pibrnik/metamaterials/Renders/BaseCell_v1.JPG

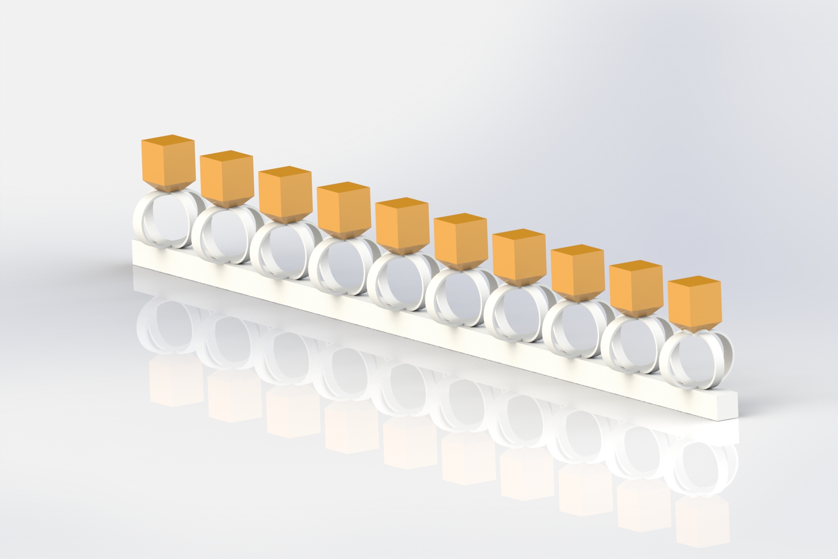
Renders/BaseCell_v1.JPG
