pibrnik/metamaterials/Renders/BaseCell_v12JPG.JPG

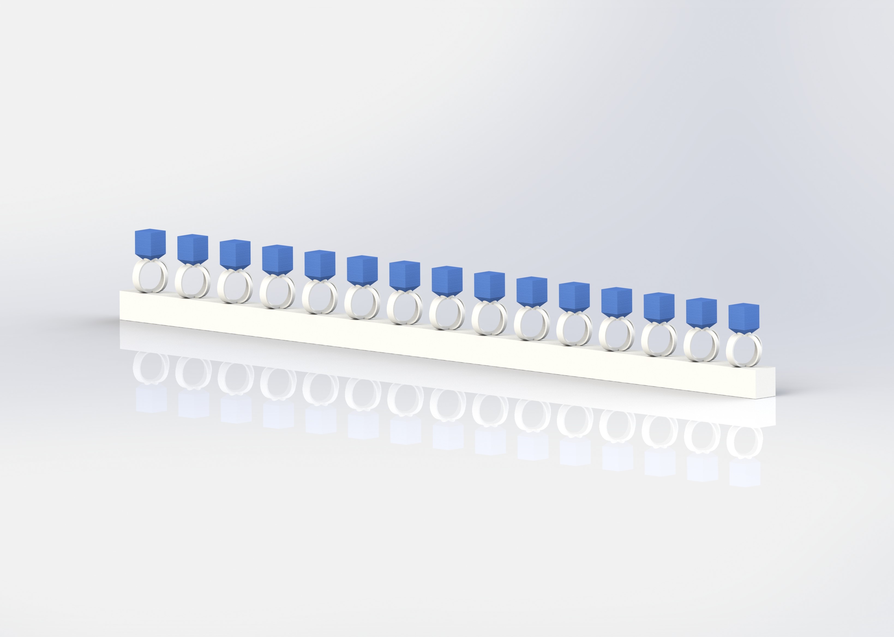
Renders/BaseCell_v12JPG.JPG
