pibrnik/metamaterials/Skica problema.png

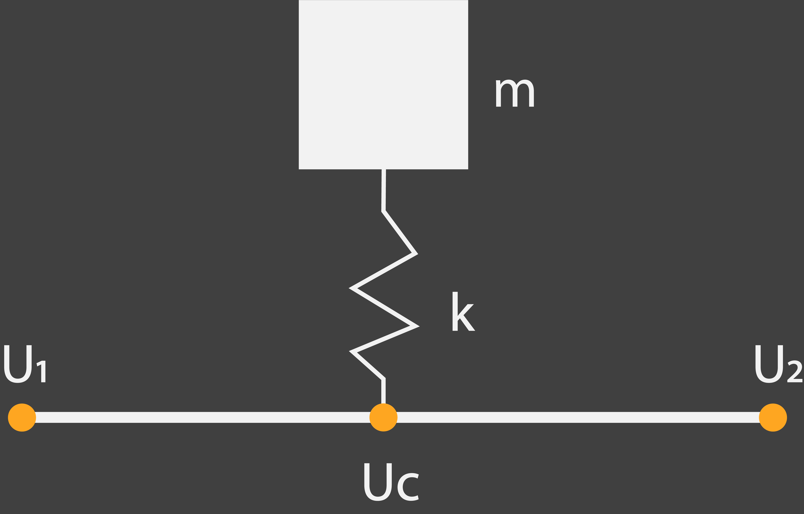
Skica problema.png
