pibrnik/metamaterials/Solidworks/BaseCell_v4.JPG

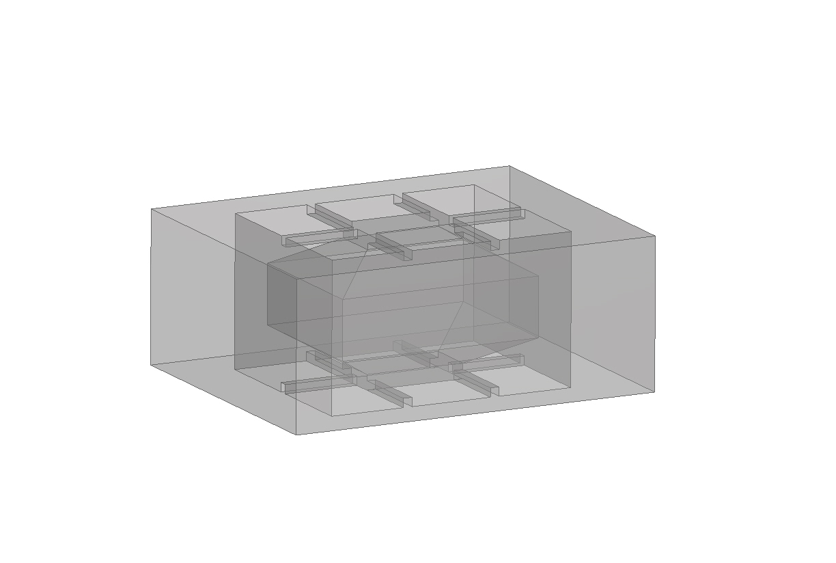
Solidworks/BaseCell_v4.JPG
