pibrnik/metamaterials/Solidworks/BaseCell_v4_drawing.JPG

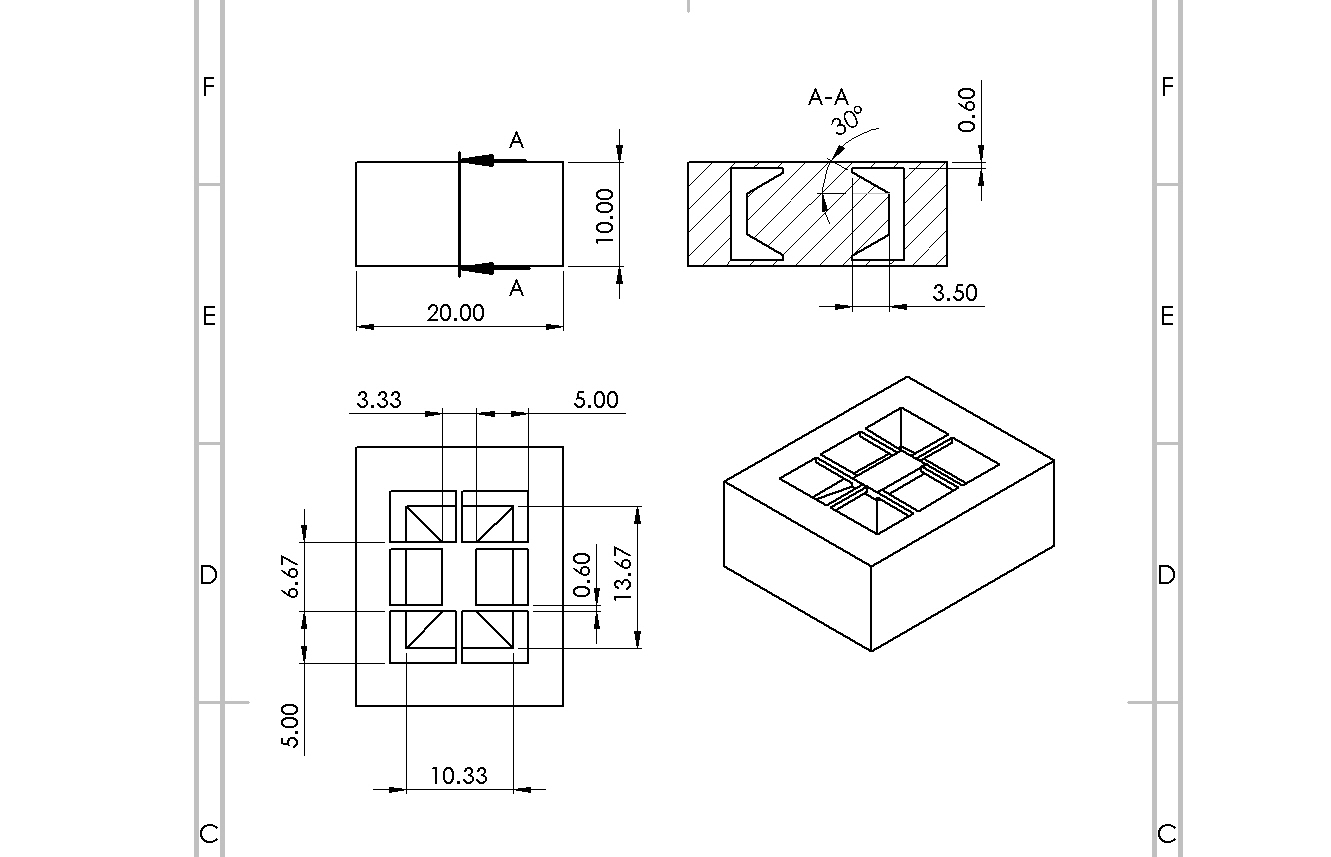
Solidworks/BaseCell_v4_drawing.JPG
