pibrnik/metamaterials/Animations/Metamaterial_oblika_1_mu_0.785.png

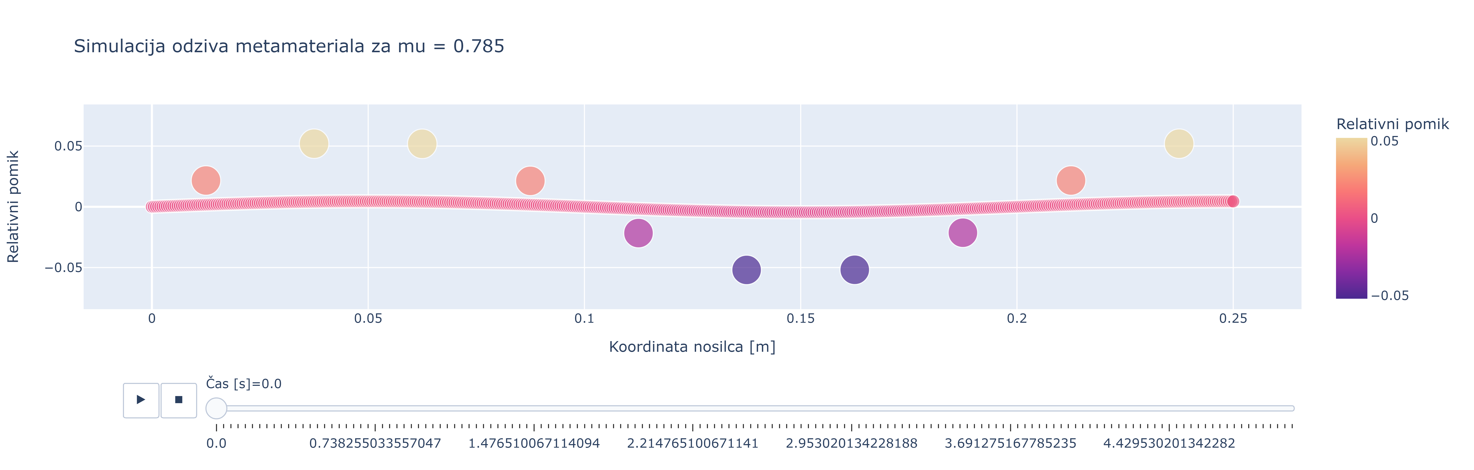
Animations/Metamaterial_oblika_1_mu_0.785.png
