pibrnik/metamaterials/Animations/Metamaterial_oblika_2_mu_0.785.png

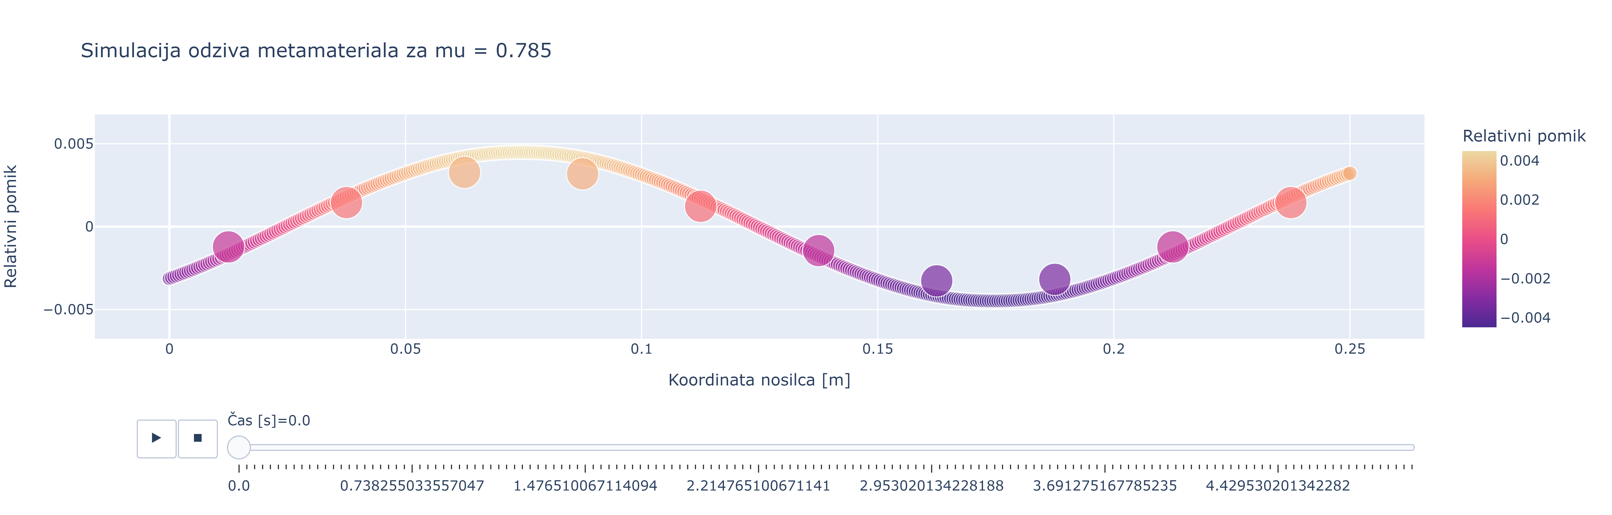
Animations/Metamaterial_oblika_2_mu_0.785.png
