pibrnik/metamaterials/Ansys/Models/Tester.STEP

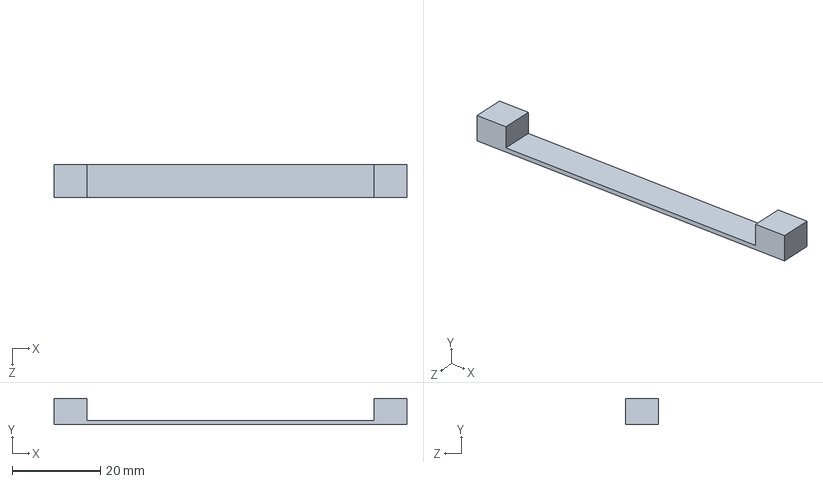
[picture p36: CAD file, 2023-01-15]
Ansys/Models/Tester.STEP
80.0 x 6.00 x 7.50 mm
