pibrnik/metamaterials/parametricBaseCell_v2.SLDPRT

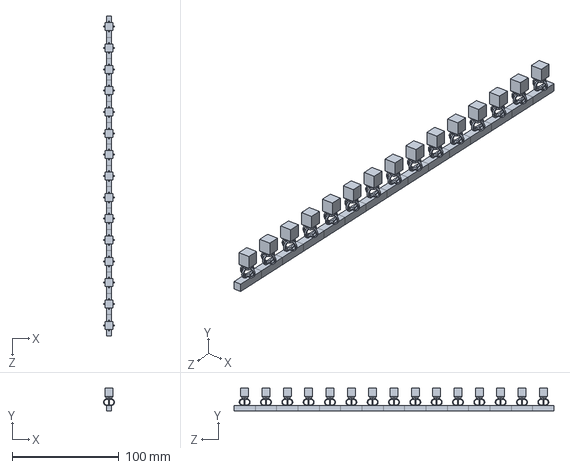
[picture p37: CAD file, 2022-12-26]
parametricBaseCell_v2.SLDPRT
10.4 x 21.4 x 300.0 mm
