pibrnik/metamaterials/Solidworks/DensityCube_15.STL

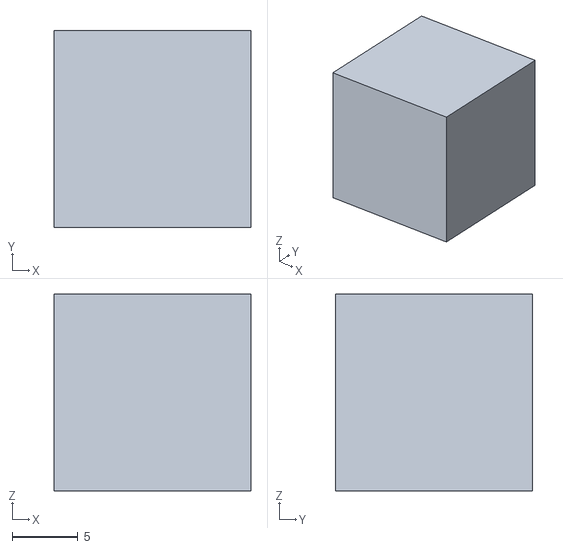
[picture p38: CAD file, 2023-01-15]
Solidworks/DensityCube_15.STL
15.0 x 15.0 x 15.0
