pibrnik/metamaterials/Ansys/Models/BaseCell_v4.STEP

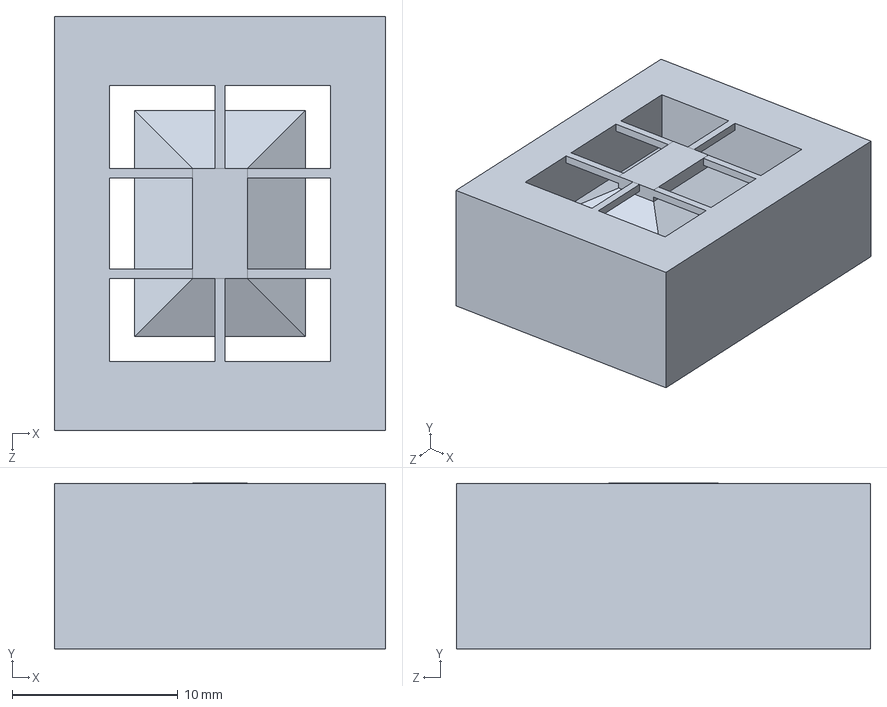
[picture p39: CAD file, 2022-12-26]
Ansys/Models/BaseCell_v4.STEP
20.0 x 10.0 x 25.0 mm
