pibrnik/metamaterials/Ansys/Models/Spring_5_0.5_2.5_2.STEP

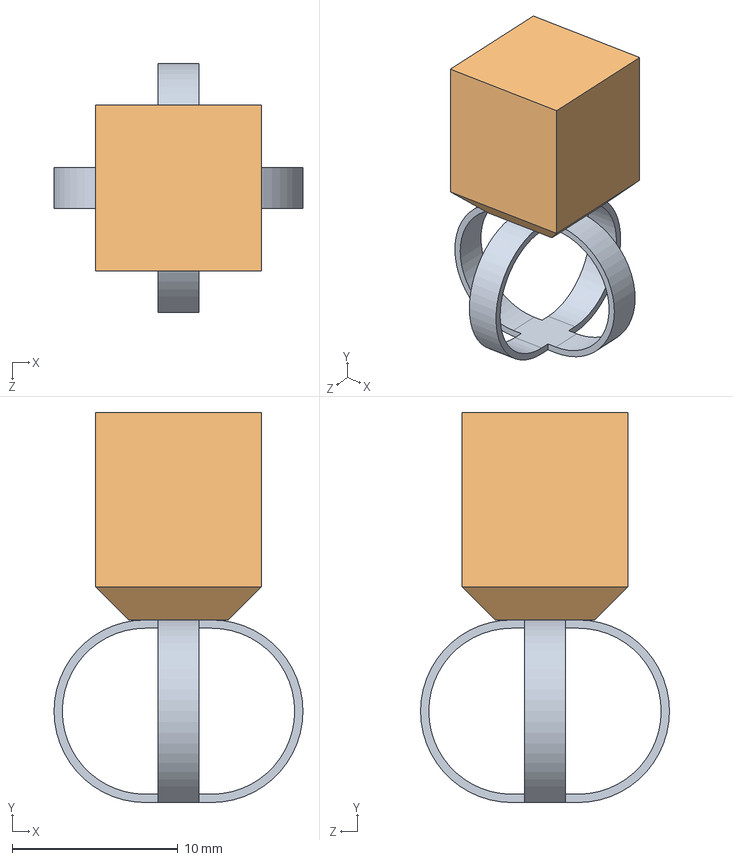
[picture p40: CAD file, 2022-12-26]
Ansys/Models/Spring_5_0.5_2.5_2.STEP
15.0 x 23.5 x 15.0 mm
