pibrnik/metamaterials/Ansys/Models/V3.SLDPRT

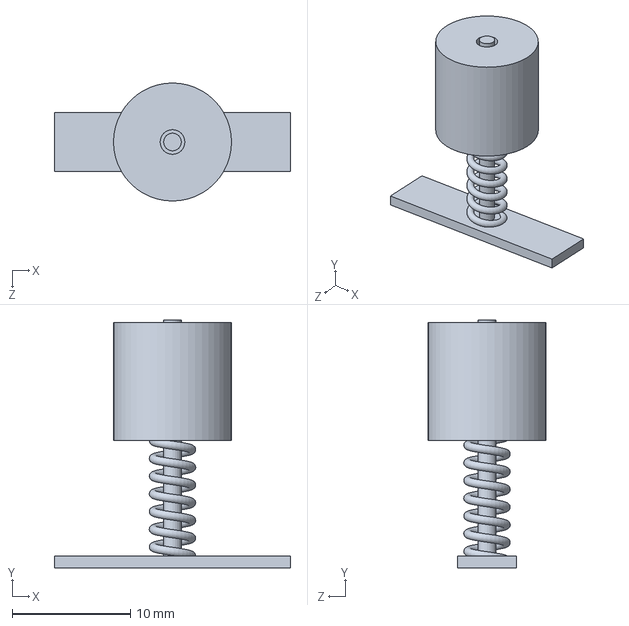
[picture p41: CAD file, 2022-12-26]
Ansys/Models/V3.SLDPRT
20.0 x 21.0 x 10.0 mm
