pibrnik/metamaterials/Solidworks/BaseCell_v4x10.STL

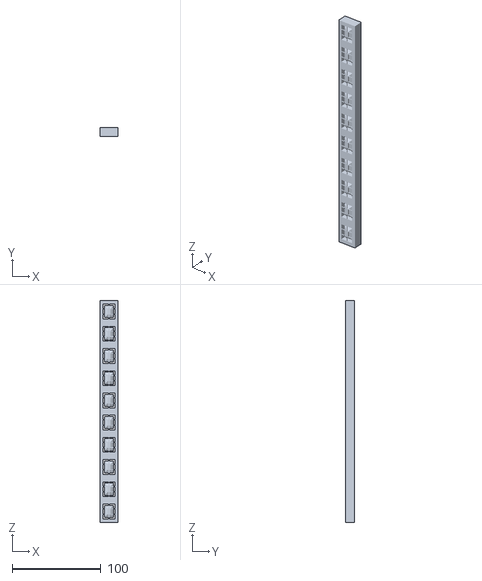
[picture p42: CAD file, 2022-12-26]
Solidworks/BaseCell_v4x10.STL
20.0 x 10.0 x 250.0
