pibrnik/metamaterials/Ansys/Models/BaseCell_v4_NM.STEP

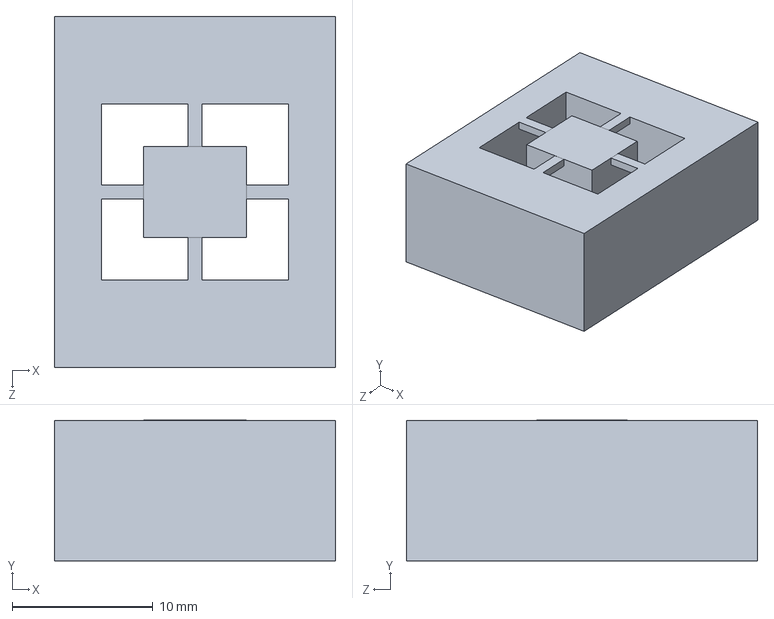
[picture p43: CAD file, 2022-12-26]
Ansys/Models/BaseCell_v4_NM.STEP
20.0 x 10.0 x 25.0 mm
