pibrnik/metamaterials/Solidworks/Spring.STEP

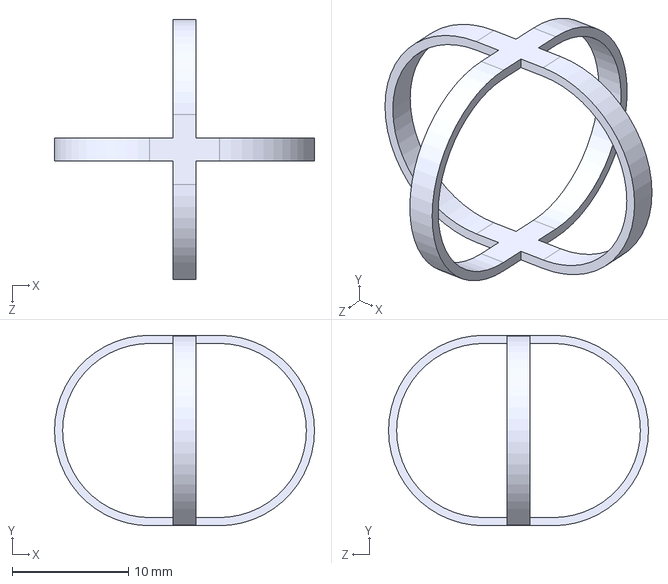
[picture p44: CAD file, 2022-12-26]
Solidworks/Spring.STEP
22.4 x 16.4 x 22.4 mm
