pibrnik/metamaterials/Ansys/Models/SpringWR_0.5_7.5_3_3.STEP

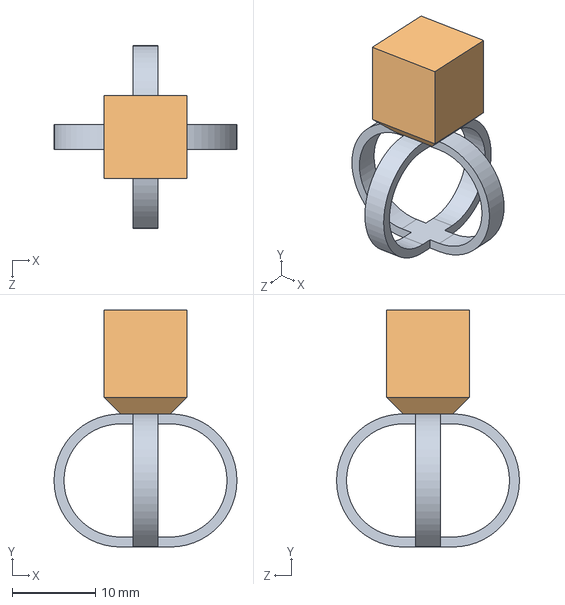
[picture p45: CAD file, 2022-12-26]
Ansys/Models/SpringWR_0.5_7.5_3_3.STEP
22.0 x 28.5 x 22.0 mm
