pibrnik/metamaterials/Solidworks/Beam.SLDPRT

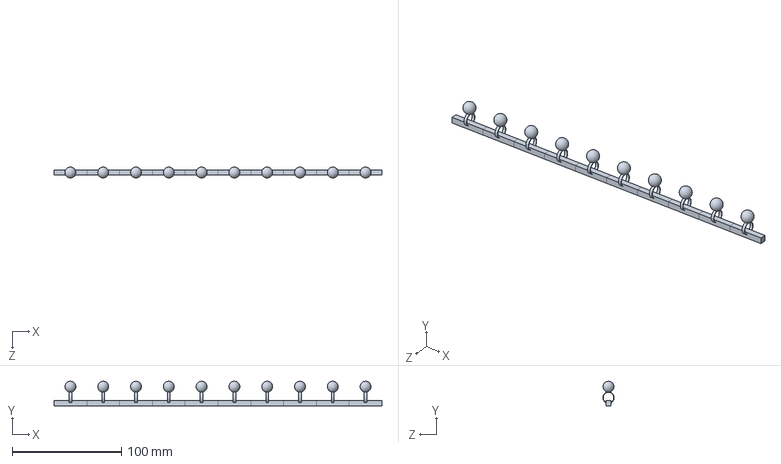
[picture p46: CAD file, 2022-11-27]
Solidworks/Beam.SLDPRT
300.0 x 22.5 x 10.4 mm
