pibrnik/metamaterials/Ansys/Models/SpringWR_0.7_5_3_3.STEP

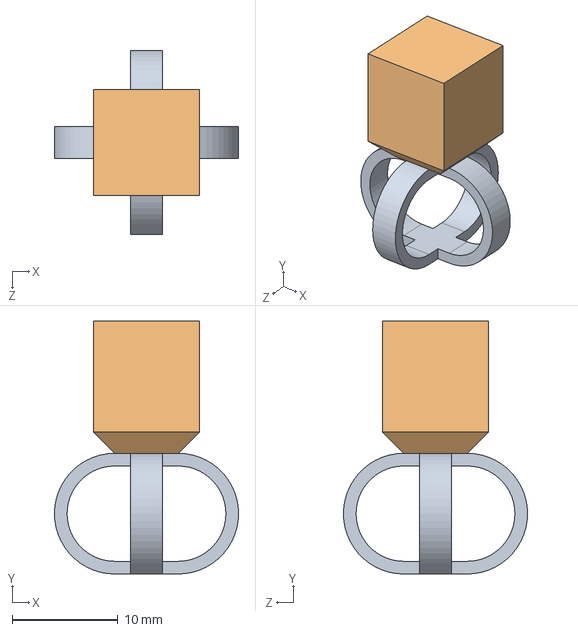
[picture p47: CAD file, 2022-12-26]
Ansys/Models/SpringWR_0.7_5_3_3.STEP
17.4 x 23.9 x 17.4 mm
