pibrnik/metamaterials/Ansys/Models/Spring_2.5_0.7_1.STEP

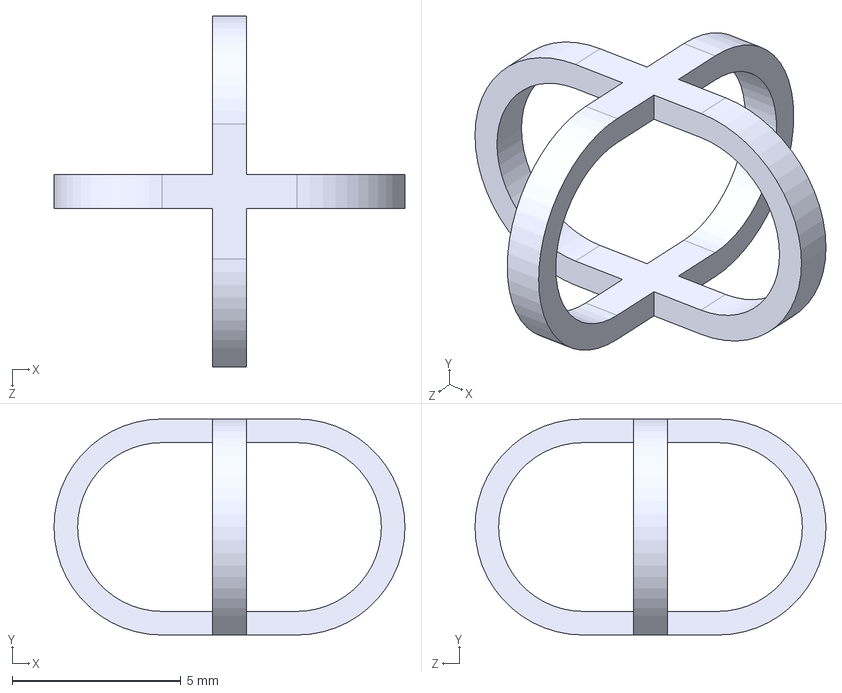
[picture p49: CAD file, 2022-12-26]
Ansys/Models/Spring_2.5_0.7_1.STEP
10.4 x 6.40 x 10.4 mm
