pibrnik/metamaterials/Ansys/Models/TestSpring.STEP

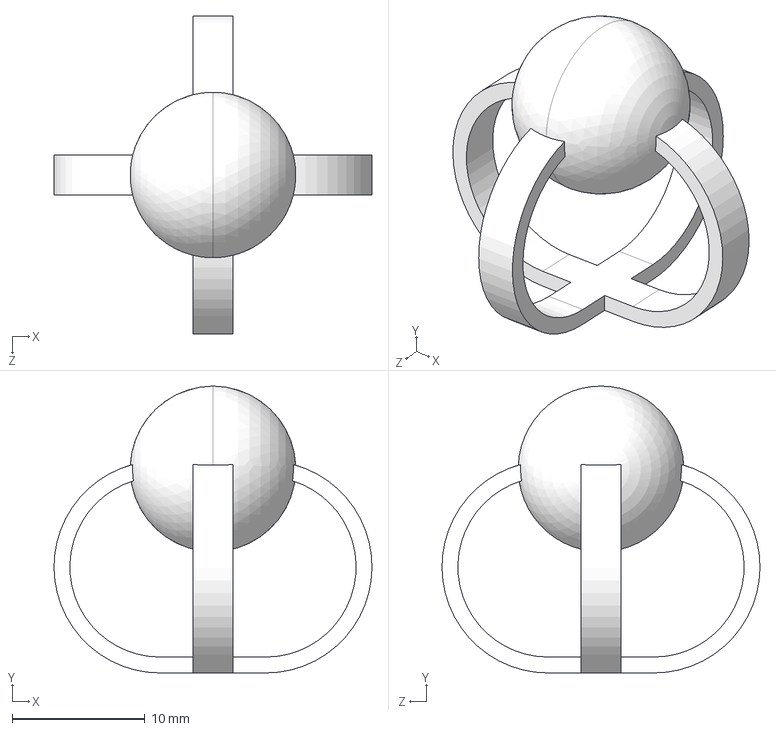
[picture p50: CAD file, 2022-12-26]
Ansys/Models/TestSpring.STEP
24.0 x 21.7 x 24.0 mm
