pibrnik/metamaterials/Ansys/Models/Spring_6_0.5_2.5_3.STEP

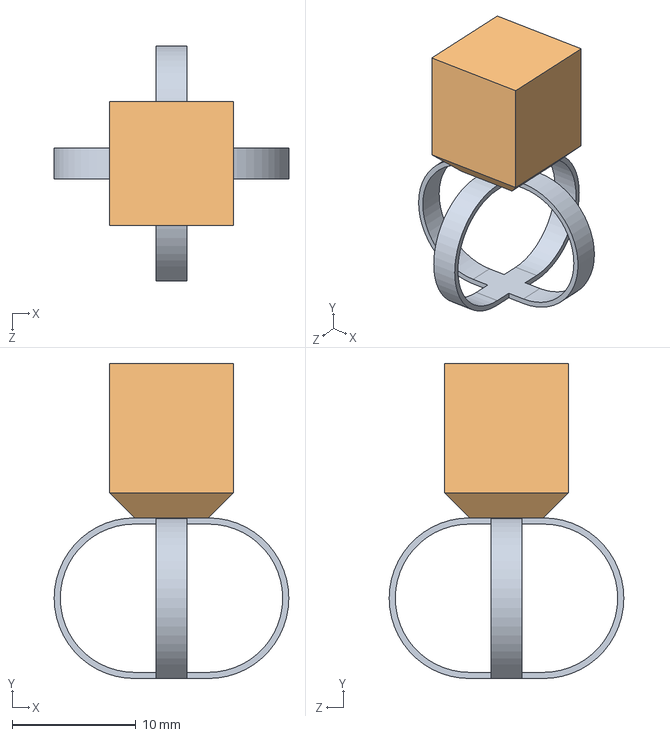
[picture p51: CAD file, 2022-12-26]
Ansys/Models/Spring_6_0.5_2.5_3.STEP
19.0 x 25.5 x 19.0 mm
