pibrnik/metamaterials/Ansys/Models/TestSpring2.STEP

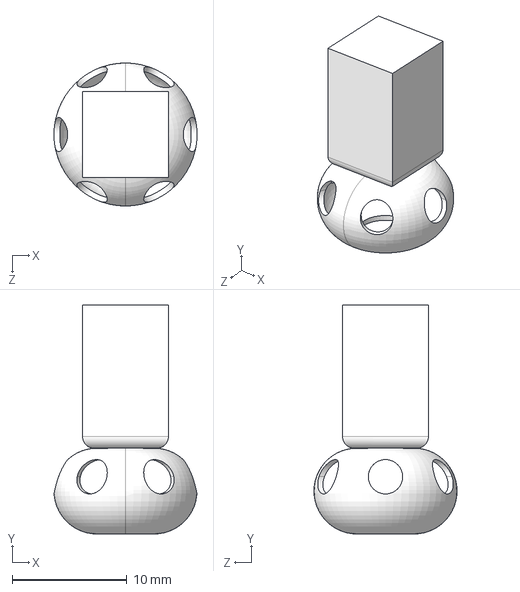
[picture p52: CAD file, 2022-12-26]
Ansys/Models/TestSpring2.STEP
12.5 x 20.0 x 12.5 mm
