pibrnik/metamaterials/Ansys/Models/SpringResonator45_2.5_0.7_1.STEP

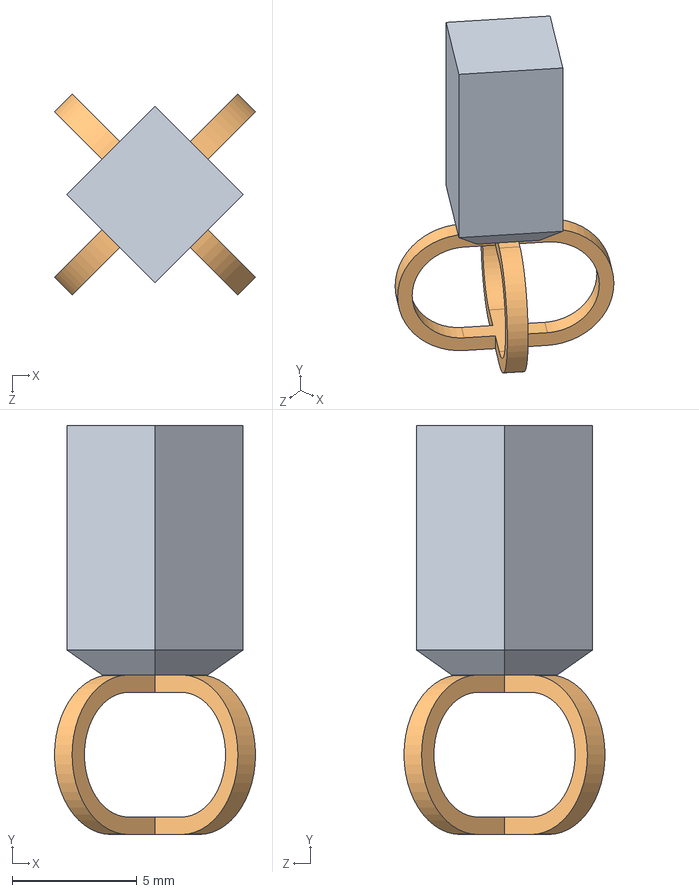
[picture p53: CAD file, 2022-12-26]
Ansys/Models/SpringResonator45_2.5_0.7_1.STEP
8.06 x 16.4 x 8.06 mm
