pibrnik/metamaterials/Ansys/Models/SpringWR_0.7_6.5_2.5_3.STEP

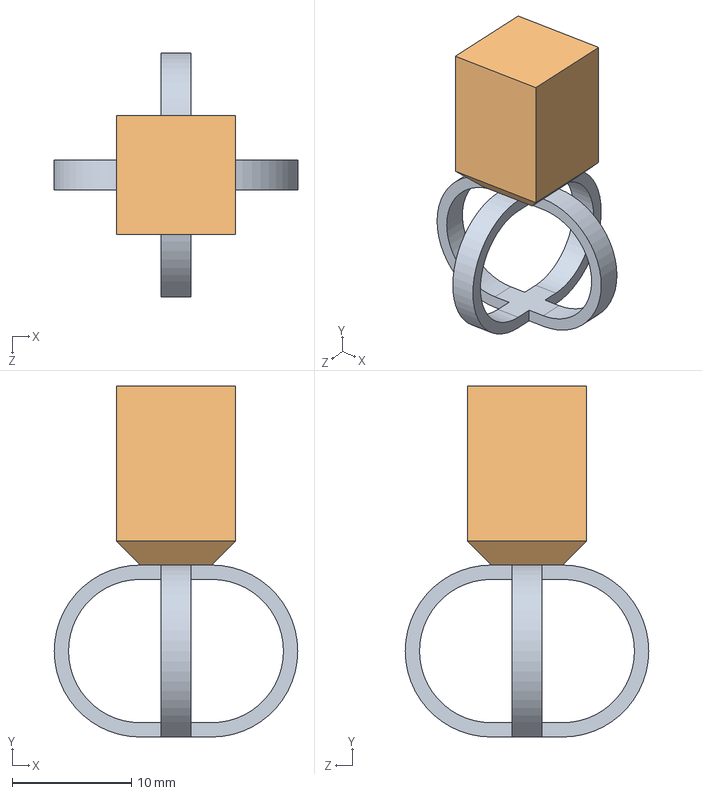
[picture p54: CAD file, 2022-12-26]
Ansys/Models/SpringWR_0.7_6.5_2.5_3.STEP
20.4 x 29.4 x 20.4 mm
