pibrnik/metamaterials/Ansys/Models/Spring_5_07_2.STEP

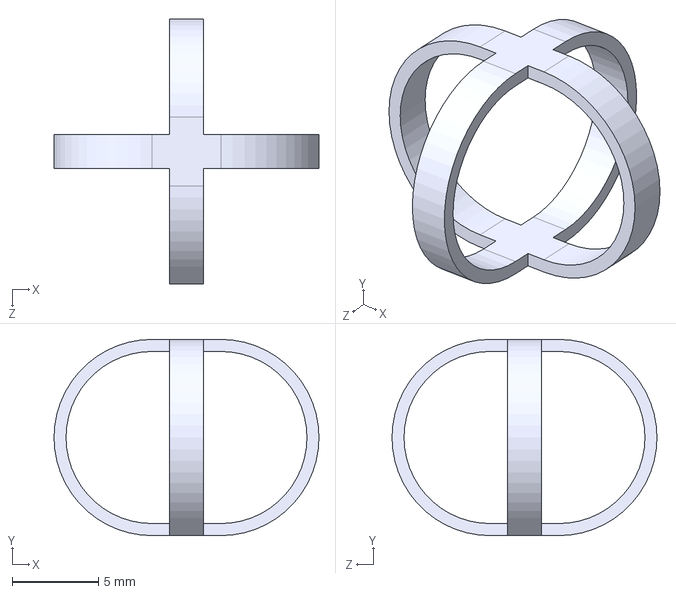
[picture p55: CAD file, 2022-12-26]
Ansys/Models/Spring_5_07_2.STEP
15.4 x 11.4 x 15.4 mm
