pibrnik/metamaterials/Ansys/Models/SpringResonator_2.5_0.7_1.STEP

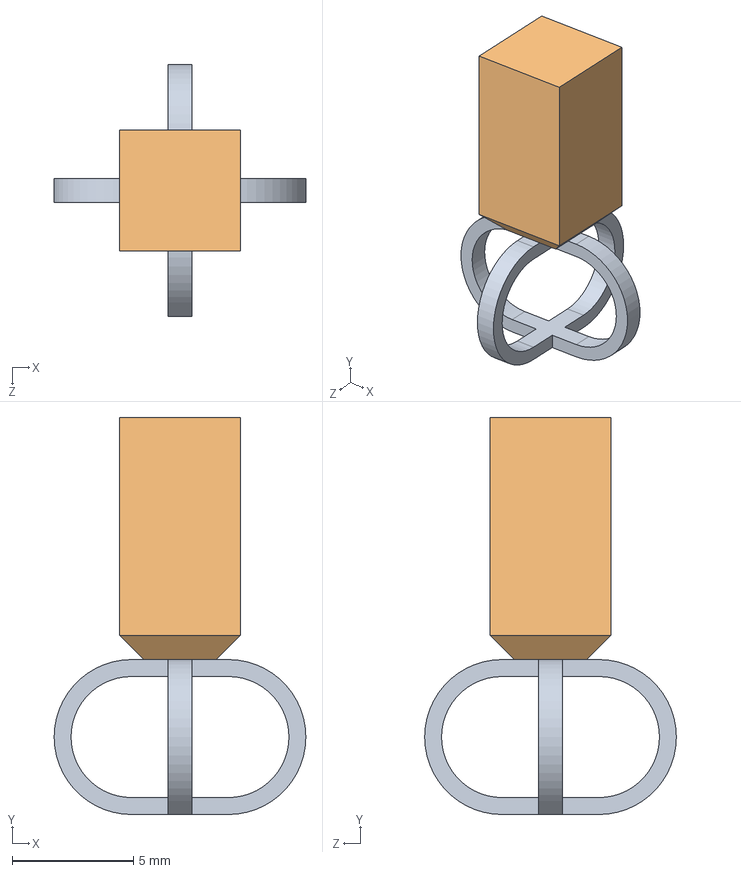
[picture p56: CAD file, 2022-12-26]
Ansys/Models/SpringResonator_2.5_0.7_1.STEP
10.4 x 16.4 x 10.4 mm
