pibrnik/metamaterials/Ansys/Models/Spring_4_0.7_2.5.STEP

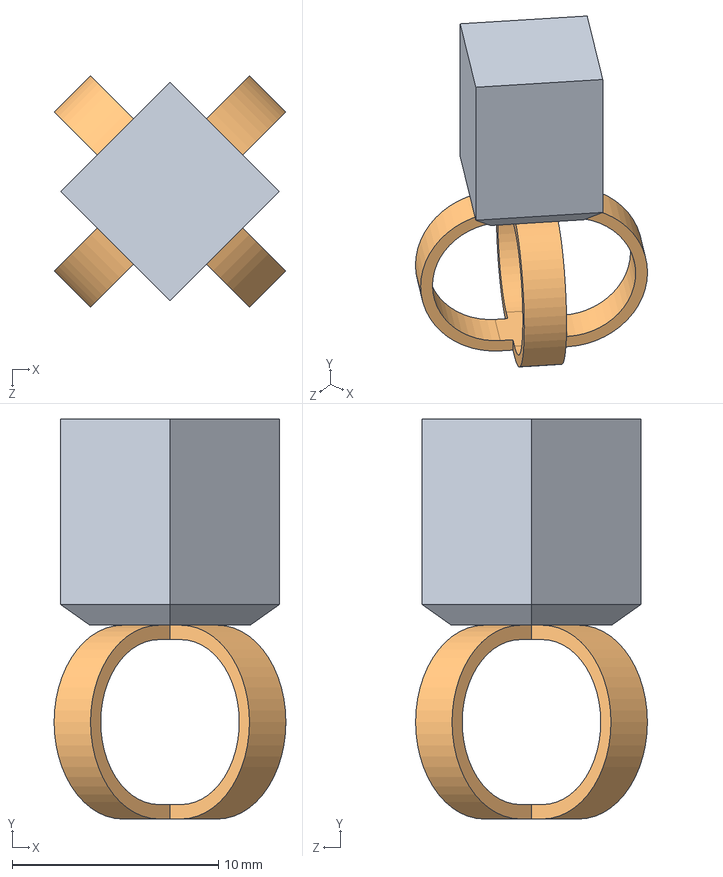
[picture p57: CAD file, 2022-12-26]
Ansys/Models/Spring_4_0.7_2.5.STEP
11.2 x 19.4 x 11.2 mm
