pibrnik/metamaterials/(list of files, cad)

Other CAD files:
Solidworks/Tester.SLDPRT
Solidworks/BaseCell_v4.SLDPRT
Ansys/Models/TestSpring3.STEP
Ansys/Models/Cudna_vzmet.SLDPRT
Solidworks/BaseCell.SLDPRT
Solidworks/BaseCell_v4.SLDDRW
Solidworks/BaseCell_v4.STL
Solidworks/Spring.SLDPRT
Solidworks/Tester.SLDDRW
Solidworks/Tester.STL
parametricBaseCell.SLDPRT
