pibrnik/metamaterials/Solidworks/tester.pdf

E E

F F

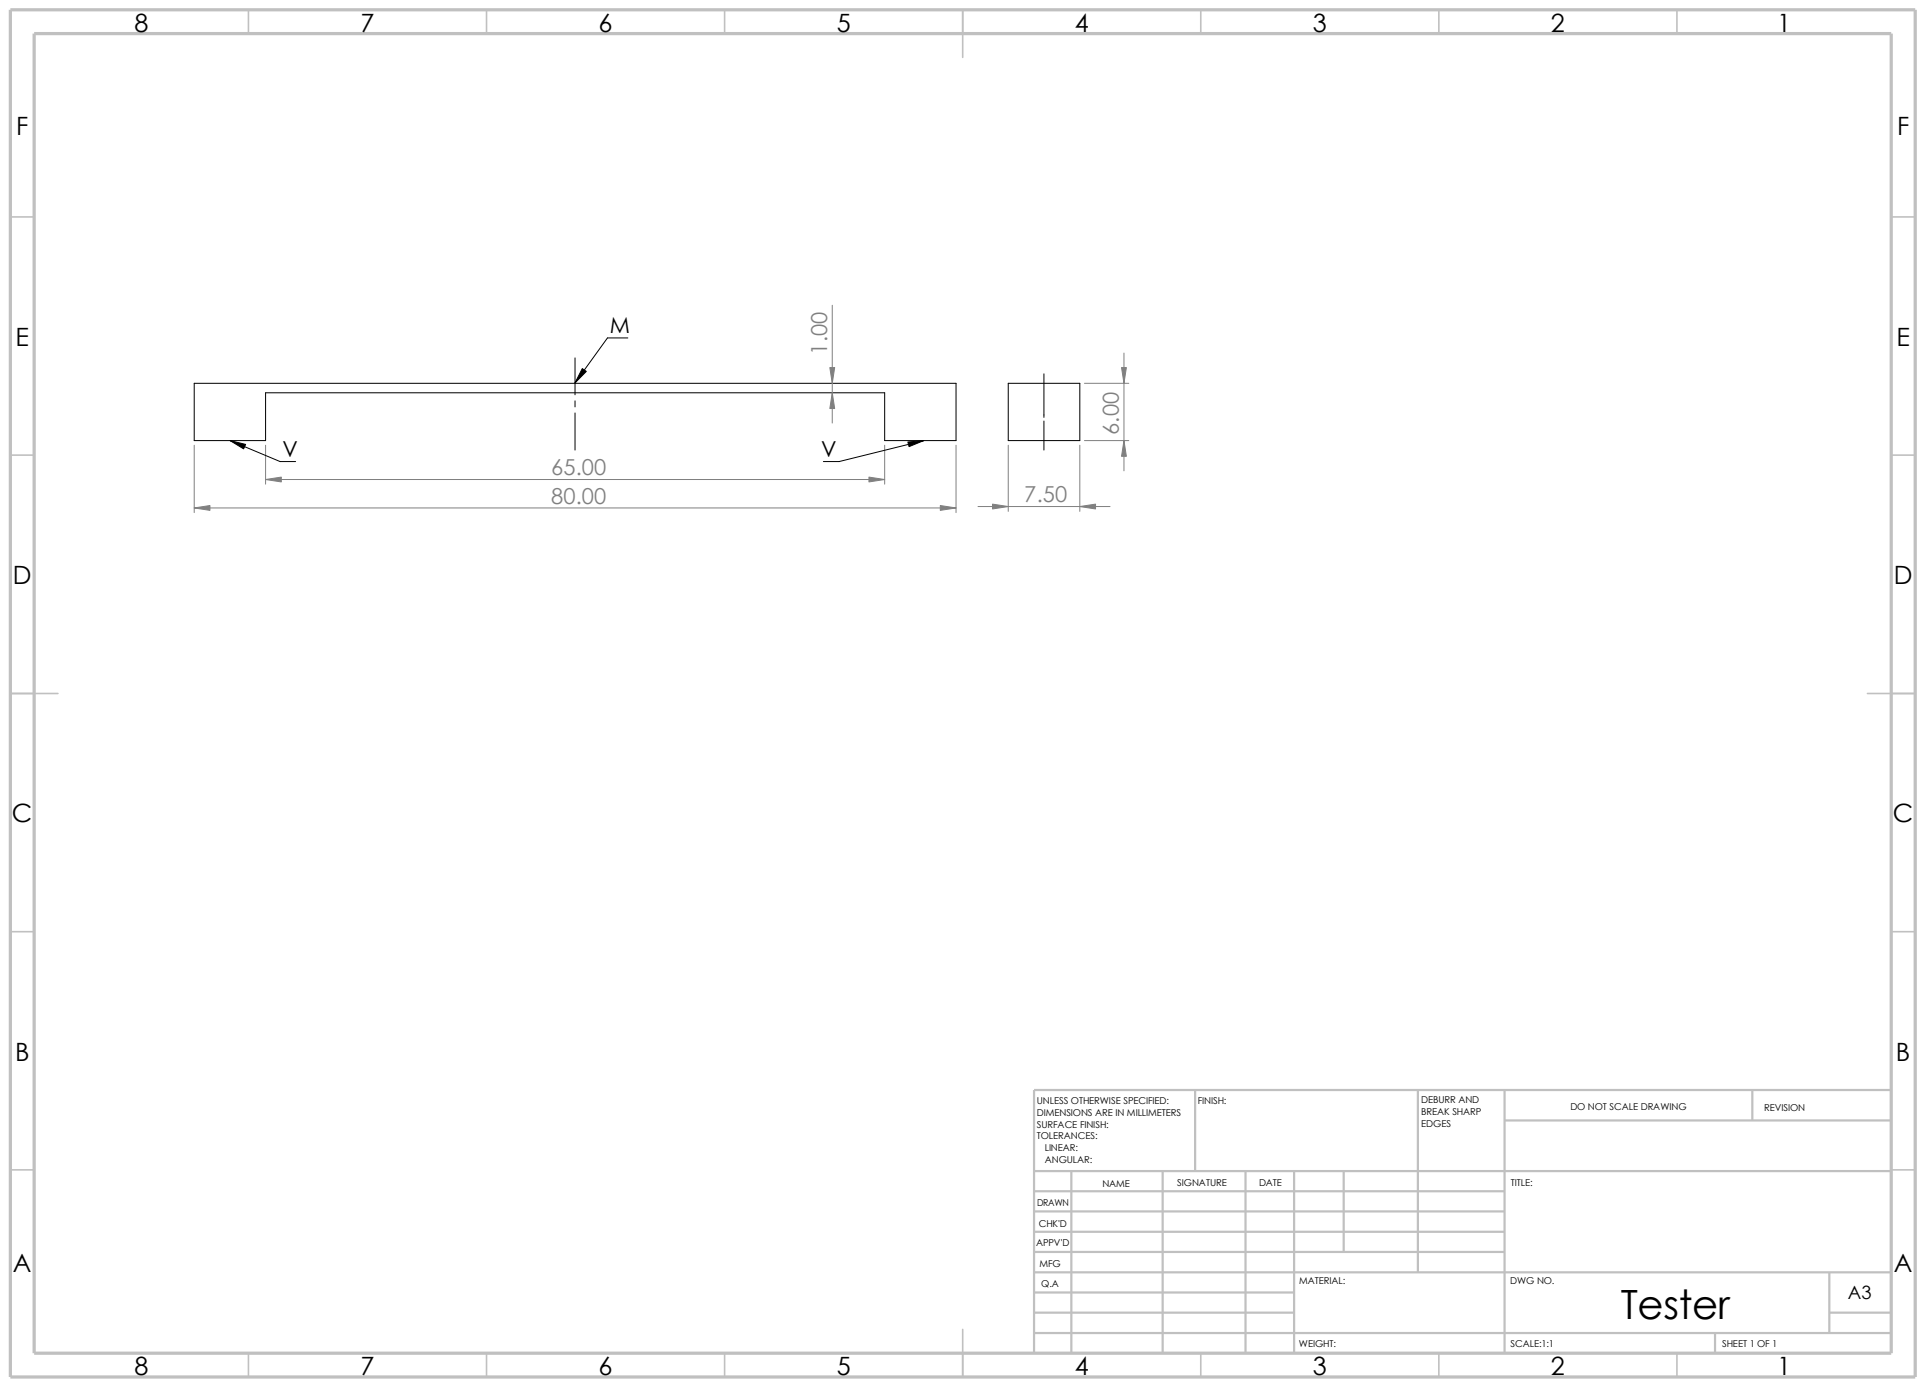
[picture p58: page 1]
DO NOT SCALE DRAWING; REVISION; SCALE:1:1; SHEET 1 OF 1; WEIGHT:; EDGES; UNLESS OTHERWISE SPECIFIED:; FINISH:; DEBURR AND BREAK SHARP

DIMENSIONS ARE IN MILLIMETERS
SURFACE FINISH:
TOLERANCES:
LINEAR:
ANGULAR:

NAME | SIGNATURE | DATE | | | | TITLE:

DRAWN
CHK'D
APPV'D

MFG
Q.A | | | | MATERIAL: | DWG NO. Tester | A3
