pibrnik/metamaterials/Solidworks/drawing.pdf

3.50
E E

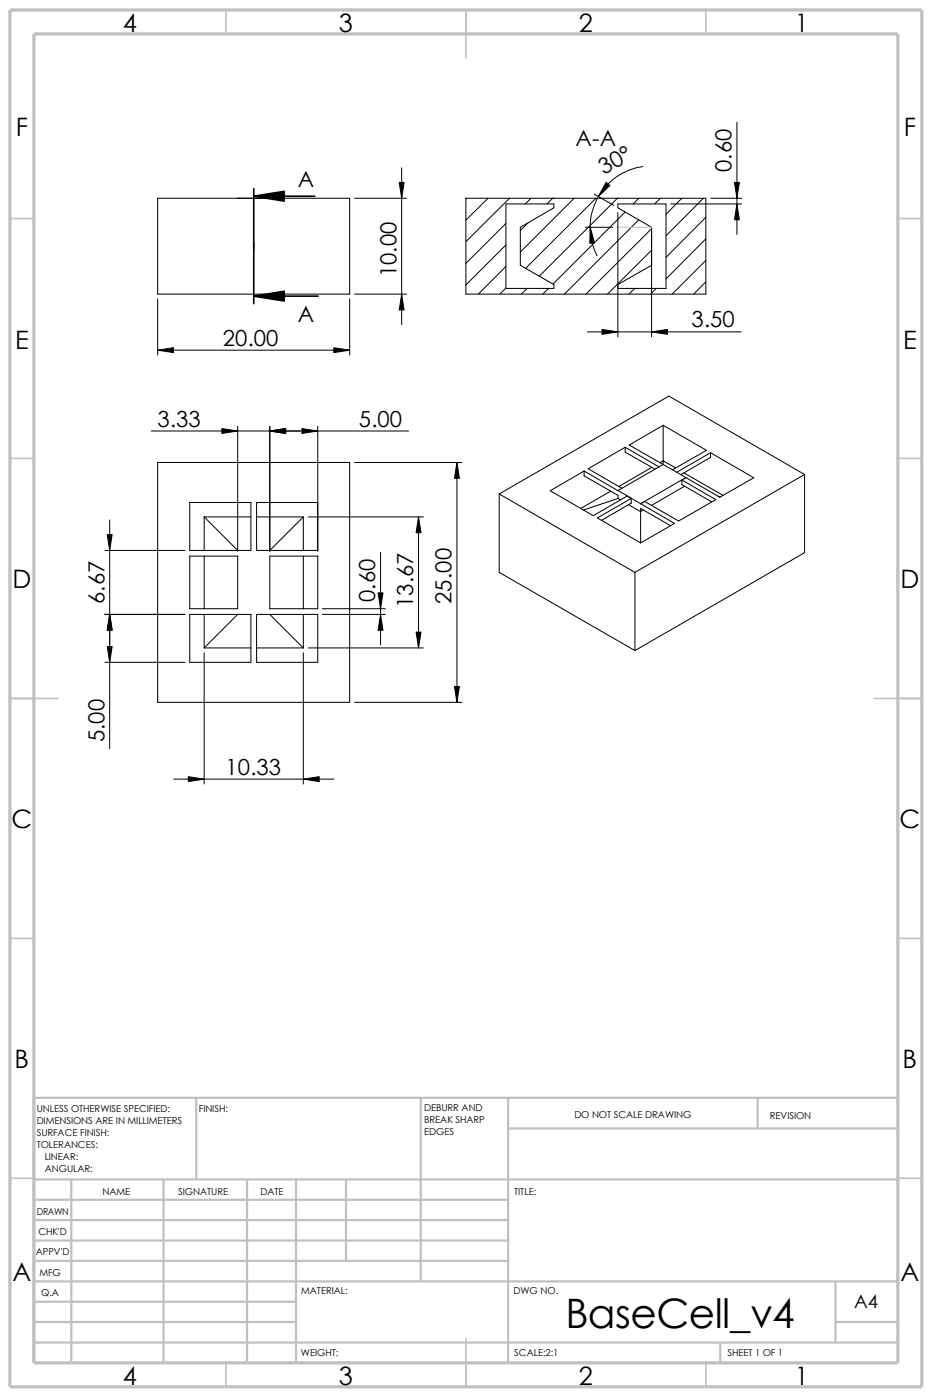
[picture p59: page 1]
MFG; DWG NO.; WEIGHT:; SCALE:2:1; SHEET 1 OF 1; FINISH:; EDGES; MATERIAL:; DO NOT SCALE DRAWING; REVISION; DEBURR AND BREAK SHARP; BaseCell_v4

UNLESS OTHERWISE SPECIFIED:
DIMENSIONS ARE IN MILLIMETERS
SURFACE FINISH:
TOLERANCES:
LINEAR:
ANGULAR:

NAME | SIGNATURE | DATE | TITLE:

DRAWN
CHK'D
APPV'D
