pibrnik/metamaterials/(commit log)

2022-11-27 Fixed Type 0 BC, Small bugs
    [BaseCell.SLDPRT, Beam.SLDPRT]
2022-12-06 Stiffness calculation for BaseCell rototype
    [parametricBaseCell.SLDPRT]
2022-12-26 Updated for BCv4 + PDF
    [BaseCell.SLDPRT, BaseCell_v4.SLDDRW, BaseCell_v4.SLDPRT, BaseCell_v4.STEP, BaseCell_v4.STL, BaseCell_v4_NM.STEP, BaseCell_v4x10.STL, Beam.SLDPRT]
2022-12-28 PDF update
    [BaseCell_v4.SLDDRW]
2022-12-30 3D tisk PDF
    [BaseCell_v4.SLDPRT]
2023-01-15 Updated documentation, simulations
    [DensityCube_15.STL, DesignPointLog.csv, Tester.SLDDRW, Tester.SLDPRT, Tester.STEP, Tester.STL, parameters.params]
